adrien-cardinale/esphome-z906-hardware/z906_hardware.csv

Reference | Qty | Value | Footprint | Datasheet | Description
C2,C6,C7,C14,C16,C18,C21,C26,C28,C30,C32 | 11 | 10uF | Capacitor_SMD:C_0805_2012Metric_Pad1.18x1.45mm_HandSolder |  | 10uF 16V X5R 10%
C4,C10 | 2 | 22uF | Capacitor_SMD:C_0805_2012Metric_Pad1.18x1.45mm_HandSolder |  | 22uF 10V X5R 20%
C8,C9,C12,C13,C15,C17,C19,C20,C27,C29,C31,C33,C39 | 13 | 100nF | Capacitor_SMD:C_0805_2012Metric_Pad1.18x1.45mm_HandSolder |  | 100nF 50V X7R 10%
C11 | 1 | 1uF | Capacitor_SMD:C_0805_2012Metric_Pad1.18x1.45mm_HandSolder |  | 1uF 16V X7R 10%
C22,C23,C34 | 3 | 2.2uF | Capacitor_SMD:C_0805_2012Metric_Pad1.18x1.45mm_HandSolder |  | 2.2uF 25V X7R 10%
C24,C25 | 2 | 2.2nF | Capacitor_SMD:C_0805_2012Metric_Pad1.18x1.45mm_HandSolder |  | 2.2nF 50V C0G 5%
C35,C37 | 2 | 10uF | Capacitor_SMD:C_1206_3216Metric_Pad1.33x1.80mm_HandSolder |  | 10uF 25V X7R 10%
D1 | 1 | PESD5V0S1UB | Diode_SMD:D_SOD-523
F1 | 1 | 0ZLM0075FF2G | Fuse:Fuse_0603_1608Metric_Pad1.05x0.95mm_HandSolder |  | Resettable fuse, polymeric positive temperature coefficient
FB1,FB3,FB4 | 3 | 600Ohm@100MHz | Resistor_SMD:R_0805_2012Metric_Pad1.20x1.40mm_HandSolder |  | BLM21SP601SN1D
J1 | 1 | USB_C_Receptacle_USB2.0_16P | Connector_USB:USB_C_Receptacle_GCT_USB4105-xx-A_16P_TopMnt_Horizontal | https://www.usb.org/sites/default/files/documents/usb_type-c.zip | USB 2.0-only 16P Type-C Receptacle connector
J5 | 1 | Ampli | Connector_TE-Connectivity:TE_Micro-MaTch_1-215079-6_2x08_P1.27mm_Vertical |  | Generic connector, single row, 01x15, script generated
J6 | 1 | Console | Connector_Dsub:DSUB-15-HD_Pins_Horizontal_P2.29x1.90mm_EdgePinOffset3.03mm_Housed_MountingHolesOffset4.94mm |  | Generic connector, single row, 01x15, script generated
JP1 | 1 | reset | TestPoint:TestPoint_2Pads_Pitch2.54mm_Drill0.8mm |  | Jumper, 2-pole, open
JP2 | 1 | boot | TestPoint:TestPoint_2Pads_Pitch2.54mm_Drill0.8mm |  | Jumper, 2-pole, open
L1 | 1 | 1.0uH | Inductor_SMD:L_1008_2520Metric_Pad1.43x2.20mm_HandSolder |  | DFE252012F-1R0M
R1,R2 | 2 | 5.1k | Resistor_SMD:R_0805_2012Metric_Pad1.20x1.40mm_HandSolder |  | Resistor
R3 | 1 | 453k | Resistor_SMD:R_0805_2012Metric_Pad1.20x1.40mm_HandSolder |  | Resistor
R4,R20,R21,R22,R23,R24,R25,R34 | 8 | 0 | Resistor_SMD:R_0805_2012Metric_Pad1.20x1.40mm_HandSolder |  | Resistor
R5,R27,R28,R29,R35 | 5 | 10k | Resistor_SMD:R_0805_2012Metric_Pad1.20x1.40mm_HandSolder |  | Resistor
R6,R7 | 2 | 470 | Resistor_SMD:R_0805_2012Metric_Pad1.20x1.40mm_HandSolder |  | Resistor
R8,R10,R11 | 3 | 100k | Resistor_SMD:R_0805_2012Metric_Pad1.20x1.40mm_HandSolder |  | Resistor
R13,R16,R17,R18,R19 | 5 | 1k | Resistor_SMD:R_0805_2012Metric_Pad1.20x1.40mm_HandSolder |  | Resistor
R14,R15,R31,R32,R33 | 5 | 22 | Resistor_SMD:R_0805_2012Metric_Pad1.20x1.40mm_HandSolder |  | Resistor
R26,R30 | 2 | 0 | Resistor_SMD:R_0805_2012Metric_Pad1.20x1.40mm_HandSolder |  | Resistor
TP2 | 1 | RXD0 | Connector_Pin:Pin_D1.0mm_L10.0mm |  | test point
TP3 | 1 | TXD0 | Connector_Pin:Pin_D1.0mm_L10.0mm |  | test point
TP4 | 1 | 3.3VA | Connector_Pin:Pin_D1.0mm_L10.0mm |  | test point
TP5 | 1 | GND | Connector_Pin:Pin_D1.0mm_L10.0mm |  | test point
TP6 | 1 | 3.3V | Connector_Pin:Pin_D1.0mm_L10.0mm |  | test point
U1 | 1 | ESP32-S3-WROOM-1 | RF_Module:ESP32-S3-WROOM-1 | https://www.espressif.com/sites/default/files/documentation/esp32-s3-wroom-1_wroom-1u_datasheet_en.pdf | RF Module, ESP32-S3 SoC, Wi-Fi 802.11b/g/n, Bluetooth, BLE, 32-bit, 3.3V, onboard antenna, SMD
U2 | 1 | TPS62A02APDDC | Package_TO_SOT_SMD:SOT-23-6 | https://www.ti.com/lit/gpn/tps62a02a | High Efficiency Synchronous Buck Converter with forced PWM, Adjustable Output 0.6V-5.5V, 2A, Power Good, Enable, SOT-23-6
U3 | 1 | PCM5102A | Package_SO:TSSOP-20_4.4x6.5mm_P0.65mm | https://www.ti.com/lit/ds/symlink/pcm5102a.pdf | 2.1 VRMS, 112dB Audio Stereo DAC with PLL and 32-bit, 384kHz PCM Interface, TSSOP-20
U4 | 1 | TPD2EUSB30 | Package_TO_SOT_SMD:Texas_DRT-3 | http://www.ti.com/lit/ds/symlink/tpd2eusb30a.pdf | 2-Channel ESD Protection for Super-Speed USB 3.0 Interface, DRT-3
U6 | 1 | TPS7A4533DCQ | Package_TO_SOT_SMD:SOT-223-6_TabPin3 | https://www.ti.com/lit/ds/symlink/tps7a45.pdf | Low-Noise Fast-Transient-Response 1.5A LDO Regulator, Fixed Output, Vin = 20V max, eN = 35 μVrms
U7 | 1 | PCM1860DBT | Package_SO:TSSOP-30_4.4x7.8mm_P0.5mm | https://www.ti.com/lit/ds/symlink/pcm1860.pdf | 2-Channel, 192 kHz, 24-bit, Audio ADC, 103dB SNR, I2S / left-justified digital output formats, hardware control interface, TSSOP-30
