adrien-cardinale/esphome-z906-hardware/z906_hardware_mouser.csv

Mfr Part Number | Manufacturer | Quantity | Customer Part Number | Description
RC0805JR-070RL | Yageo | 10 | R4,R20,R21,R22,R23,R24,R25,R34 | 0R 0805 (8 used)
RC0805FR-0722RL | Yageo | 10 | R14,R15,R31,R32,R33 | 22R 1% 0805 (5 used)
RC0805FR-07470RL | Yageo | 10 | R6,R7 | 470R 1% 0805 (2 used)
RC0805FR-071KL | Yageo | 10 | R13,R16,R17,R18,R19 | 1k 1% 0805 (5 used)
RC0805FR-075K1L | Yageo | 10 | R1,R2 | 5.1k 1% 0805 (2 used)
RC0805FR-0710KL | Yageo | 10 | R5,R27,R28,R29,R35 | 10k 1% 0805 (5 used)
RC0805FR-07100KL | Yageo | 10 | R8,R10,R11 | 100k 1% 0805 (3 used)
RC0805FR-07453KL | Yageo | 10 | R3 | 453k 1% 0805 (1 used)
CL21B104KBCNNNC | Samsung Electro-Mechanics | 20 | C8,C9,C12,C13,C15,C17,C19,C20,C27,C29,C31,C33,C39 | 100nF 50V X7R 0805 (13 used)
C2012X5R1C106K085AC | TDK | 20 | C2,C6,C7,C14,C16,C18,C21,C26,C28,C30,C32 | 10uF 16V X5R 0805 (11 used)
CL21A226MQQNNNE | Samsung Electro-Mechanics | 10 | C4,C10 | 22uF 6.3V X5R 0805 (2 used)
GRM21BR71C105KA01L | Murata | 10 | C11 | 1uF 16V X7R 0805 (1 used)
CL21B225KAFNNNE | Samsung Electro-Mechanics | 10 | C22,C23,C34 | 2.2uF 25V X7R 0805 (3 used)
CL21C222JBFNNNE | Samsung Electro-Mechanics | 10 | C24,C25 | 2.2nF 50V C0G 0805 (2 used)
CL31B106KOHNNNE | Samsung Electro-Mechanics | 4 | C35,C37 | 10uF 16V X7R 1206 (2 used)
BLM21PG600SN1D | Murata | 10 | FB1,FB3,FB4 | Ferrite 600R@100MHz 3A 0805 (3 used)
DFE252012F-1R0M=P2 | Murata | 1 | L1 | 1uH 3.3A 2520
SMAJ5.0A-E3/61 | Vishay | 2 | D1 | TVS 5V 400W SMA DO-214AC (1 used)
0ZLM0075FF2G | Bel Fuse | 1 | F1 | PTC 0.75A 0603
ESP32-S3-WROOM-1-N8R8 | Espressif | 1 | U1 | ESP32-S3 module 8MB flash 8MB PSRAM
TPS62A02APDDCR | Texas Instruments | 1 | U2 | Buck 2A forced PWM SOT-23-6
PCM5102APWR | Texas Instruments | 1 | U3 | DAC TSSOP-20
TPD2EUSB30ADRTR | Texas Instruments | 1 | U4 | USB ESD DRT-3
TPS7A4533DCQR | Texas Instruments | 1 | U6 | LDO 3.3V SOT-223-6
PCM1860DBTR | Texas Instruments | 1 | U7 | ADC TSSOP-30
USB4105-GF-A | GCT | 1 | J1 | USB-C receptacle 16P
1-215079-6 | TE Connectivity | 1 | J5 | Micro-MaTch 16 pos vertical
L717HDE15PD1CH4F | Amphenol | 1 | J6 | HD15 male right angle 4-40
61304011121 | Wurth Elektronik | 1 | TP2,TP3,TP4,TP5,TP6,JP1,JP2 | Pin header 1x40 2.54mm to cut (9 pins used)
60900213421 | Wurth Elektronik | 2 | JP1,JP2 | Jumper 2.54mm
