adrien-cardinale/esphome-z906-hardware/z906_hardware_digikey.csv

Quantity | Part Number | Customer Reference
10 | 311-0.0ARCT-ND | R4 R20 R21 R22 R23 R24 R25 R34
10 | 311-22.0CRCT-ND | R14 R15 R31 R32 R33
10 | 311-470CRCT-ND | R6 R7
10 | 311-1.00KCRCT-ND | R13 R16 R17 R18 R19
10 | 311-5.10KCRCT-ND | R1 R2
10 | 311-10.0KCRCT-ND | R5 R27 R28 R29 R35
10 | 311-100KCRCT-ND | R8 R10 R11
10 | 311-453KCRCT-ND | R3
20 | 1276-1003-1-ND | C8 C9 C12 C13 C15 C17 C19 C20 C27 C29 C31 C33 C39
20 | 445-7644-1-ND | C2 C6 C7 C14 C16 C18 C21 C26 C28 C30 C32
10 | 1276-1100-1-ND | C4 C10
10 | 490-1691-1-ND | C11
10 | 1276-2954-1-ND | C22 C23 C34
10 | 1276-2993-1-ND | C24 C25
4 | 1276-1082-1-ND | C35 C37
10 | 490-1053-1-ND | FB1 FB3 FB4
1 | 490-13053-1-ND | L1
2 | SMAJ5.0A-E3/61GICT-ND | D1
1 | 5923-0ZLM0075FF2GCT-ND | F1
1 | 5407-ESP32-S3-WROOM-1-N8R8CT-ND | U1
1 | 296-TPS62A02APDDCRCT-ND | U2
1 | 296-36707-1-ND | U3
1 | 296-28153-1-ND | U4
1 | 296-37002-1-ND | U6
1 | 296-PCM1860DBCT-ND | U7
1 | 2073-USB4105-GF-ACT-ND | J1
1 | 1-215079-6 | J5
1 | L717HDE15PD1CH4F | J6
1 | 61304011121 | TP2 TP3 TP4 TP5 TP6 JP1 JP2
2 | 60900213421 | JP1 JP2
