adrien-cardinale/esphome-z906-hardware/z906_hardware.kicad_pcb

## KiCad design z906_hardware.kicad_pcb (2026-10-27)

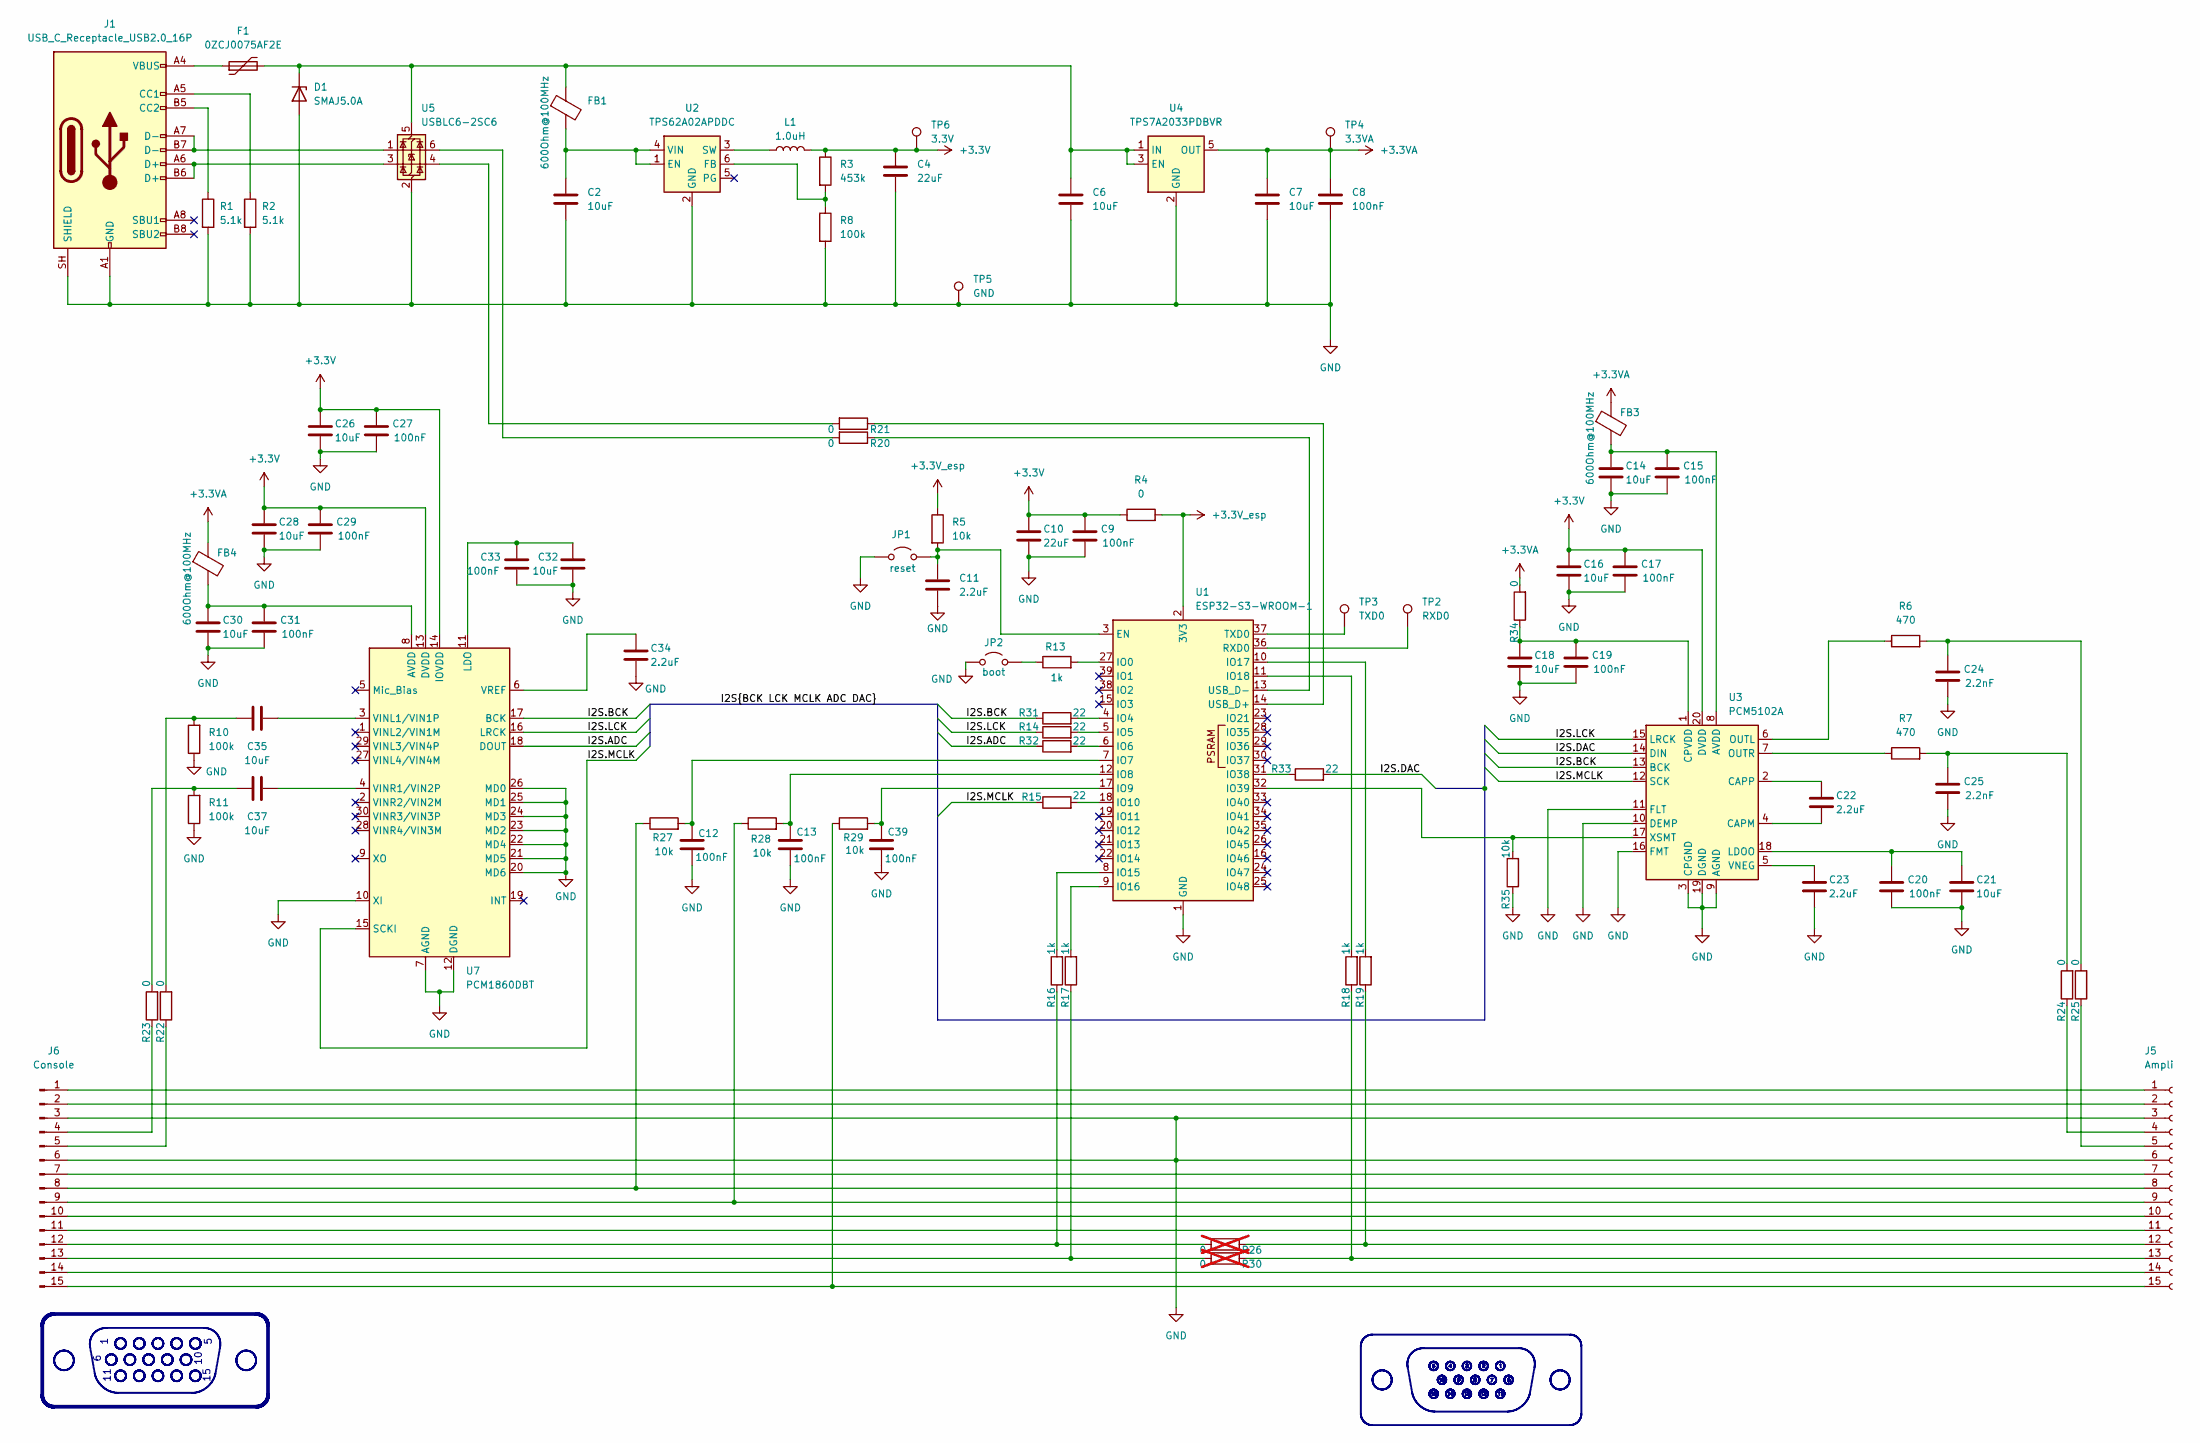
[picture p1: schematic z906_hardware.kicad_sch, ESPHome Z906]

Parts:
C2, C6, C7, C14, C16, C18, C21, C26, C28, C30, C32: 10uF; C_0805_2012Metric_Pad1.18x1.45mm_HandSolder
C4, C10: 22uF; C_0805_2012Metric_Pad1.18x1.45mm_HandSolder
C8, C9, C12, C13, C15, C17, C19, C20, C27, C29, C31, C33, C39: 100nF; C_0805_2012Metric_Pad1.18x1.45mm_HandSolder
C11, C22, C23, C34: 2.2uF; C_0805_2012Metric_Pad1.18x1.45mm_HandSolder
C24, C25: 2.2nF; C_0805_2012Metric_Pad1.18x1.45mm_HandSolder
C35, C37: 10uF; C_1206_3216Metric_Pad1.33x1.80mm_HandSolder
D1: SMAJ5.0A; D_SMA
F1: 0ZCJ0075AF2E; Fuse_1210_3225Metric
FB1, FB3, FB4: 600Ohm@100MHz; R_0805_2012Metric_Pad1.20x1.40mm_HandSolder
J1: USB_C_Receptacle_USB2.0_16P; USB_C_Receptacle_GCT_USB4105-xx-A_16P_TopMnt_Horizontal
J5: Ampli; TE_Micro-MaTch_1-215079-6_2x08_P1.27mm_Vertical
J6: Console; DSUB-15-HD_Pins_Horizontal_P2.29x1.90mm_EdgePinOffset3.03mm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
JP1: reset; TestPoint_2Pads_Pitch2.54mm_Drill0.8mm
JP2: boot; TestPoint_2Pads_Pitch2.54mm_Drill0.8mm
L1: 1.0uH; L_1008_2520Metric_Pad1.43x2.20mm_HandSolder
R1, R2: 5.1k; R_0805_2012Metric_Pad1.20x1.40mm_HandSolder
R3: 453k; R_0805_2012Metric_Pad1.20x1.40mm_HandSolder
R4, R20, R21, R22, R23, R24, R25, R34: 0; R_0805_2012Metric_Pad1.20x1.40mm_HandSolder
R5, R27, R28, R29, R35: 10k; R_0805_2012Metric_Pad1.20x1.40mm_HandSolder
R6, R7: 470; R_0805_2012Metric_Pad1.20x1.40mm_HandSolder
R8, R10, R11: 100k; R_0805_2012Metric_Pad1.20x1.40mm_HandSolder
R13, R16, R17, R18, R19: 1k; R_0805_2012Metric_Pad1.20x1.40mm_HandSolder
R14, R15, R31, R32, R33: 22; R_0805_2012Metric_Pad1.20x1.40mm_HandSolder
R26, R30: 0; R_0805_2012Metric_Pad1.20x1.40mm_HandSolder; not fitted
TP2: RXD0; Pin_D1.0mm_L10.0mm
TP3: TXD0; Pin_D1.0mm_L10.0mm
TP4: 3.3VA; Pin_D1.0mm_L10.0mm
TP5: GND; Pin_D1.0mm_L10.0mm
TP6: 3.3V; Pin_D1.0mm_L10.0mm
U1: ESP32-S3-WROOM-1
U2: TPS62A02APDDC; SOT-23-6
U3: PCM5102A; TSSOP-20_4.4x6.5mm_P0.65mm
U4: TPS7A2033PDBVR; SOT-23-5
U5: USBLC6-2SC6; SOT-23-6
U7: PCM1860DBT; TSSOP-30_4.4x7.8mm_P0.5mm

Connections:
+3.3V: C4.1, C9.1, C10.1, C16.1, C17.1, C26.1, C27.1, C28.1, C29.1, L1.2, R3.1, R4.1, TP6.1 (1_1), U3.20 (DVDD), U7.13 (DVDD), U7.14 (IOVDD)
+3.3VA: C7.1, C8.1, FB3.1, FB4.1, R34.2, TP4.1 (1_1), U4.5 (OUT)
+3.3V_esp: R4.2, R5.1, U1.2 (3V3)
/I2S.ADC: R32.1, U7.18 (DOUT)
/I2S.BCK: R31.1, U3.13 (BCK), U7.17 (BCK)
/I2S.DAC: R33.2, U3.14 (DIN)
/I2S.LCK: R14.1, U3.15 (LRCK), U7.16 (LRCK)
/I2S.MCLK: R15.1, U3.12 (SCK), U7.15 (SCKI)
GND: C2.2, C4.2, C6.2, C7.2, C8.2, C9.2, C10.2, C11.2, C12.2, C13.2, C14.2, C15.2, C16.2, C17.2, C18.2, C19.2, C20.2, C21.2, C23.2, C24.2, C25.2, C26.2, C27.2, C28.2, C29.2, C30.2, C31.2, C32.2, C33.2, C34.2, C39.2, D1.2 (A), J1.A1 (GND), J1.A12 (GND), J1.B1 (GND), J1.B12 (GND), J1.SH (SHIELD), J5.3, J5.6, J6.3, J6.6, JP1.1 (A), JP2.1 (A), R1.2, R2.2, R8.2, R10.1, R11.1, R35.1, TP5.1 (1_1), U1.1 (GND), U1.40 (GND), U1.41 (GND), U2.2 (GND), U3.3 (CPGND), U3.9 (AGND), U3.10 (DEMP), U3.11 (FLT), U3.16 (FMT), U3.19 (DGND), U4.2 (GND), U5.2 (GND), U7.7 (AGND), U7.10 (XI), U7.12 (DGND), U7.20 (MD6), U7.21 (MD5), U7.22 (MD4), U7.23 (MD2), U7.24 (MD3), U7.25 (MD1), U7.26 (MD0)
unnamed: C24.1, R6.2, R25.2
unnamed: C25.1, R7.2, R24.2
unnamed: C35.1, R10.2, R22.2
unnamed: C37.1, R11.2, R23.2
unnamed: C6.1, D1.1 (K), F1.2, FB1.1, U4.1 (IN), U4.3 (EN), U5.5 (VBUS)
unnamed: F1.1, J1.A4 (VBUS), J1.A9 (VBUS), J1.B4 (VBUS), J1.B9 (VBUS)
unnamed: J1.A5 (CC1), R2.1
unnamed: J1.B5 (CC2), R1.1
unnamed: J1.A6 (D+), J1.B6 (D+), U5.3 (I/O2)
unnamed: J1.A7 (D-), J1.B7 (D-), U5.1 (I/O1)
unnamed: J5.1, J6.1
unnamed: J5.2, J6.2
unnamed: J5.4, R24.1
unnamed: J5.5, R25.1
unnamed: J5.7, J6.7
unnamed: J5.8, J6.8, R27.1
unnamed: J5.9, J6.9, R28.1
unnamed: J5.10, J6.10
unnamed: J5.11, J6.11
unnamed: J5.12, R19.1, R26.1
unnamed: J5.13, R18.1, R30.1
unnamed: J5.14, J6.14
unnamed: J5.15, J6.15, R29.1
unnamed: J6.4, R23.1
unnamed: J6.5, R22.1
unnamed: J6.12, R16.1, R26.2
unnamed: J6.13, R17.1, R30.2
unnamed: C11.1, JP1.2 (B), R5.2, U1.3 (EN)
unnamed: JP2.2 (B), R13.1
unnamed: R20.2, U5.6 (I/O1)
unnamed: R21.2, U5.4 (I/O2)
unnamed: R13.2, U1.27 (IO0)
unnamed: R31.2, U1.4 (IO4)
unnamed: R14.2, U1.5 (IO5)
unnamed: R32.2, U1.6 (IO6)
unnamed: C12.1, R27.2, U1.7 (IO7)
unnamed: C13.1, R28.2, U1.12 (IO8)
unnamed: C39.1, R29.2, U1.17 (IO9)
unnamed: R15.2, U1.18 (IO10)
unnamed: R16.2, U1.8 (IO15)
unnamed: R17.2, U1.9 (IO16)
unnamed: R19.2, U1.10 (IO17)
unnamed: R18.2, U1.11 (IO18)
unnamed: R33.1, U1.31 (IO38)
unnamed: R35.2, U1.32 (IO39), U3.17 (XSMT)
unnamed: TP2.1 (1_1), U1.36 (RXD0)
unnamed: TP3.1 (1_1), U1.37 (TXD0)
unnamed: R21.1, U1.14 (USB_D+)
unnamed: R20.1, U1.13 (USB_D-)
unnamed: C2.1, FB1.2, U2.1 (EN), U2.4 (VIN)
unnamed: R3.2, R8.1, U2.6 (FB)
unnamed: L1.1, U2.3 (SW)
unnamed: C14.1, C15.1, FB3.2, U3.8 (AVDD)
unnamed: C22.2, U3.4 (CAPM)
unnamed: C22.1, U3.2 (CAPP)
unnamed: C18.1, C19.1, R34.1, U3.1 (CPVDD)
unnamed: C20.1, C21.1, U3.18 (LDOO)
unnamed: R6.1, U3.6 (OUTL)
unnamed: R7.1, U3.7 (OUTR)
unnamed: C23.1, U3.5 (VNEG)
unnamed: C30.1, C31.1, FB4.2, U7.8 (AVDD)
unnamed: C32.1, C33.1, U7.11 (LDO)
unnamed: C35.2, U7.3 (VINL1/VIN1P)
unnamed: C37.2, U7.4 (VINR1/VIN2P)
unnamed: C34.1, U7.6 (VREF)

Board: 2 copper layers, 89 parts (0 on the bottom side), 74 nets, no tracks yet.
