adrien-cardinale/esphome-z906-hardware/(commit log)

2026-08-15 correct file name
    [z906_hardware.kicad_pcb, z906_hardware.kicad_sch]
2026-08-15 dsub connection
    [z906_hardware.kicad_sch]
2026-09-04 change dc-dc power
    [z906_hardware.kicad_sch]
2026-09-05 usb input
    [z906_hardware.kicad_sch]
2026-09-05 numeric alimentation
    [z906_hardware.kicad_sch]
2026-09-05 analog power
    [z906_hardware.kicad_sch]
2026-09-05 add filter to analog power
    [z906_hardware.kicad_sch]
2026-09-05 add pcm1860
    [z906_hardware.kicad_sch]
2026-09-06 esp32 power
    [z906_hardware.kicad_sch]
2026-09-06 jumper boot and reset
    [z906_hardware.kicad_sch]
2026-09-09 start layout
    [z906_hardware.kicad_pcb]
2026-09-11 various correction
    [z906_hardware.kicad_sch]
2026-09-11 change 3.3v regulator
    [z906_hardware.kicad_sch]
2026-09-15 TPS62A02APDDC 3.3 power
    [z906_hardware.kicad_sch]
2026-09-15 add polyfuse to vbus
    [z906_hardware.kicad_sch]
2026-09-15 correct buck input capacitor
    [z906_hardware.kicad_sch]
2026-09-15 remove jumper capacitor
    [z906_hardware.kicad_sch]
2026-09-15 add test point to uart0
    [z906_hardware.kicad_sch]
2026-09-16 restructure shematic
    [z906_hardware.kicad_sch]
2026-09-16 add footprint
    [z906_hardware.kicad_pcb, z906_hardware.kicad_sch]
2026-09-17 add ferrite bead before buck and avdd
    [z906_hardware.kicad_sch]
2026-09-29 add bypass for uart
    [z906_hardware.kicad_sch]
2026-09-29 correct i2s bus
    [z906_hardware.kicad_sch]
2026-09-29 correct usb tvs
    [z906_hardware.kicad_sch]
2026-10-14 use 10uF C for adc audio input
2026-10-14 use 1k ohm for uart line
